enicolas72/m-card/marketing/build/img/IMG_0931.jpg

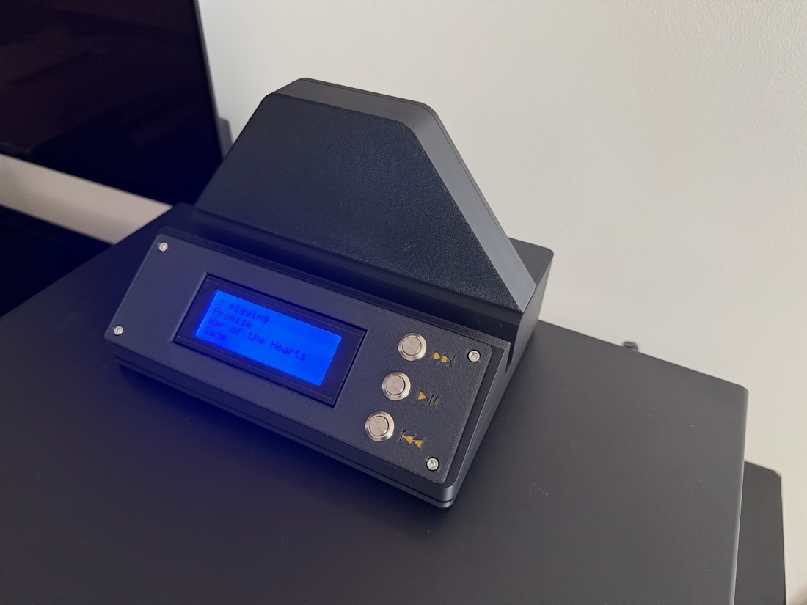
marketing/build/img/IMG_0931.jpg
