enicolas72/m-card/marketing/build/img/IMG_0930.jpg

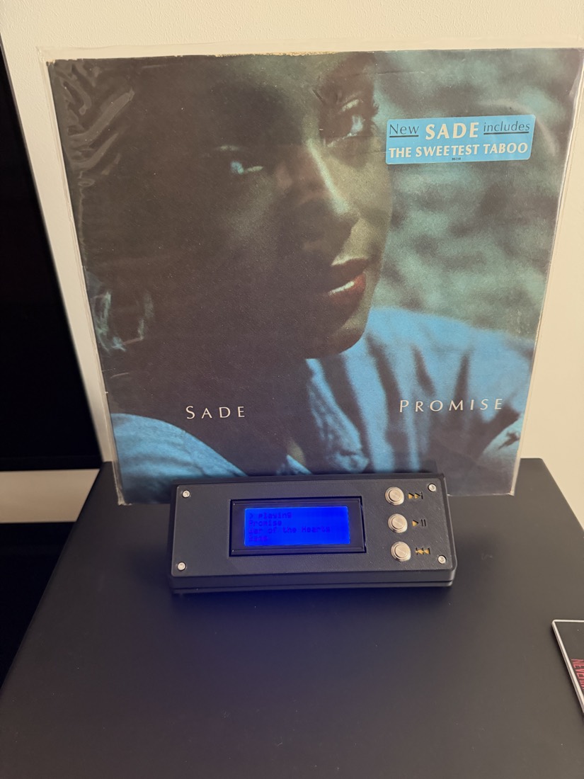
marketing/build/img/IMG_0930.jpg
