enicolas72/m-card/README.md

# M-Card

**Re-materialize your music.** One card per album, or one tucked inside the vinyl
sleeve you already own: drop it in the slot and the album plays on **Roon**. No app,
no phone, no cloud.

👉 **[See M-Card in action: interactive 3D, display, web console](https://enicolas72.github.io/m-card/marketing/)**

An open-source DIY device: Raspberry Pi 3 B+, ACR122U NFC reader, 20×4 LCD,
three push buttons, and a 3D-printed enclosure.

## Repository

The current device is **prototype 2**, archived as a whole in [`proto2/`](proto2/)
(working and in daily use; the paths below). **Prototype 3** is in progress in
[`proto3/`](proto3/), evolving from a copy of proto 2.

| Path | Contents |
|---|---|
| [`proto2/software/`](proto2/software/) | Python application (`mcard/`), sample configs, `install.sh`, systemd service, tests |
| [`proto2/docs/BOM.md`](proto2/docs/BOM.md) | bill of materials, no custom PCB |
| [`proto2/docs/WIRING.md`](proto2/docs/WIRING.md) | full wiring + [SVG diagram](proto2/docs/wiring-diagram.svg) |
| [`proto2/docs/SETUP.md`](proto2/docs/SETUP.md) | SD card, install, Roon pairing, web console, troubleshooting |
| [`proto2/docs/ASSEMBLY.md`](proto2/docs/ASSEMBLY.md) | assembly into the enclosure |
| [`proto2/enclosure/`](proto2/enclosure/) | parametric 3D enclosure (OpenSCAD) + print-ready STLs |
| [`marketing/`](marketing/) | the presentation page: one self-contained offline HTML file, sources in `marketing/build/` |

## Build one

1. **Order** the few parts listed in the [BOM](proto2/docs/BOM.md).
2. **Wire** the LCD and buttons ([WIRING.md](proto2/docs/WIRING.md)); plug the ACR122U into USB.
3. **Install** on the Pi ([SETUP.md](proto2/docs/SETUP.md)): `sudo bash install.sh`.
4. **Enable** the M-Card extension in Roon → Settings → Extensions.
5. **Pair cards**: an unknown card shows up as `TODO` in `albums.yaml`. Open
   `http://mcard.local:8088/search`, find the album, and click *Assign to this card*.
   This writes an exact Roon path, e.g. `path: ["Library", "Artists", "<artist>", "<album>"]`.
6. **Print** the enclosure and assemble it ([ASSEMBLY.md](proto2/docs/ASSEMBLY.md)).

The web console speaks English or French (`web.language: en | fr` in `mcard.yaml`).

Back up your card mappings at any time:

```bash
curl -fsS http://mcard.local:8088/config/albums.yaml/download -o backups/albums-$(date +%Y%m%d-%H%M).yaml
```

## Try it without hardware

```bash
cd proto2/software && python3 -m venv .venv && ./.venv/bin/pip install flask pyyaml pytest
./.venv/bin/python -m mcard --config <config-dir> --fake
./.venv/bin/python -m pytest tests/
```

In `--fake` mode, type a card UID + Enter to "place" a card and Enter alone to remove
it. The LCD is drawn in the terminal and Roon is simulated.

## Software architecture

A single event queue, one central controller, and one thread per peripheral. Every
hardware component has a fake twin, so development needs no Pi:

```
nfc_reader (thread) ──┐                         ┌──► roon_client ──► Roon API
buttons    (GPIO)  ───┼──► queue ──► controller ─┼──► display ──► LCD (I²C)
roon callbacks ───────┘                         └──► albums.yaml (auto TODO entries)
                    webserver (Flask): status / logs / config / Roon library search
```

## License & credits

Code, documentation and enclosure files are released under the [MIT License](LICENSE).

Independent DIY project, not affiliated with or endorsed by Roon Labs. Roon is a
trademark of Roon Labs LLC. Album artwork shown on the presentation page (and in
`marketing/build/cards/`) belongs to its respective owners and is not covered by
the MIT License.
