enicolas72/m-card/marketing/build/stl/shell.stl

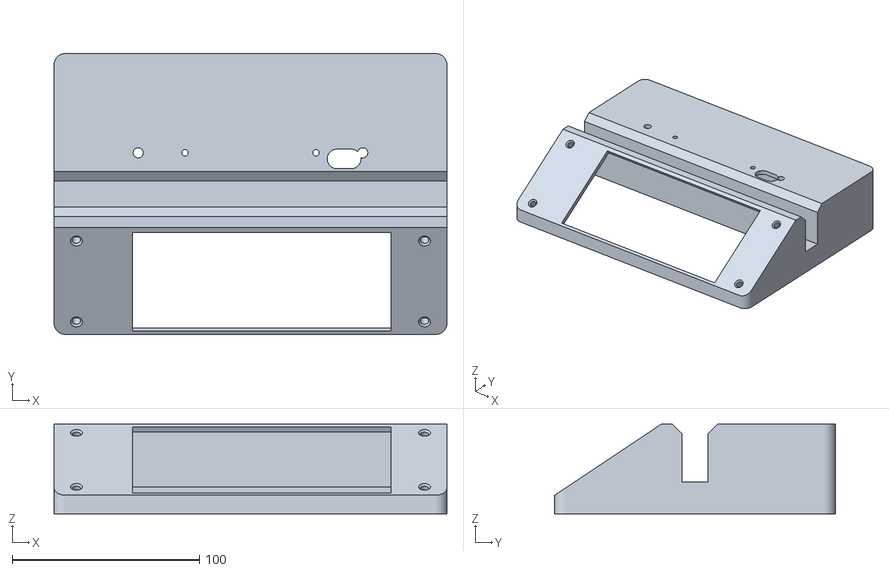
[picture p3: CAD file, 2026-10-18]
marketing/build/stl/shell.stl
210.0 x 150.0 x 48.0
