enicolas72/m-card/proto3/enclosure/stl/icon_plate.stl

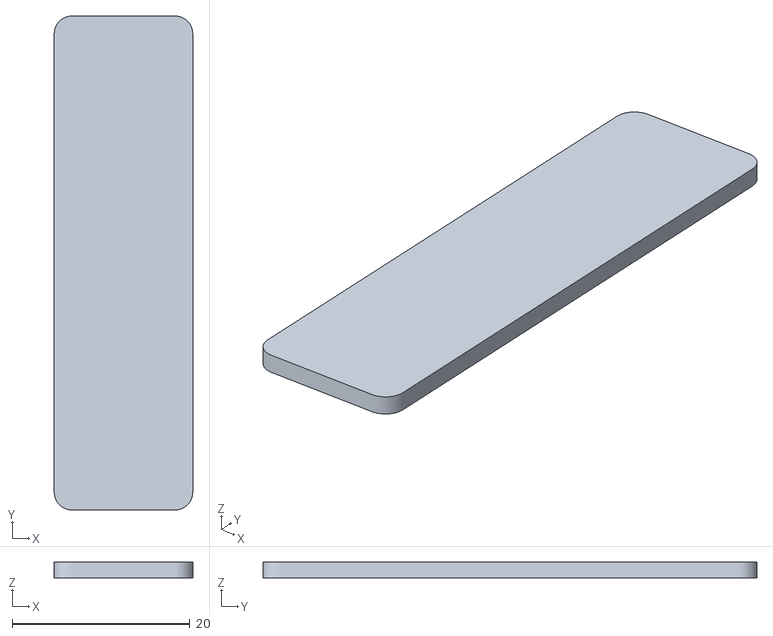
[picture p4: CAD file, 2026-07-30]
proto3/enclosure/stl/icon_plate.stl
15.6 x 55.6 x 1.80
