enicolas72/m-card/marketing/build/stl/lid.stl

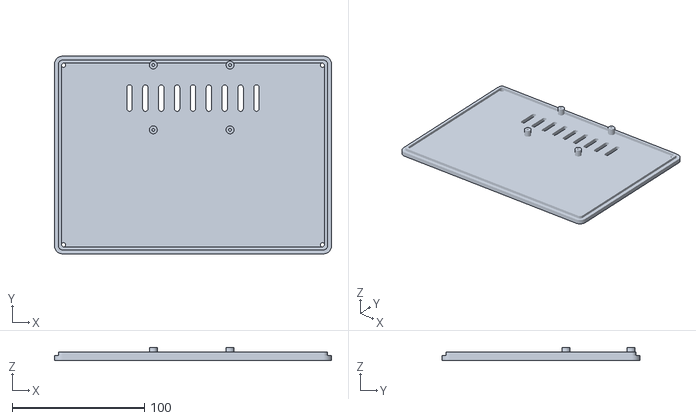
[picture p5: CAD file, 2026-10-18]
marketing/build/stl/lid.stl
209.4 x 149.4 x 9.99
