enicolas72/m-card/proto3/enclosure/stl/backrest.stl

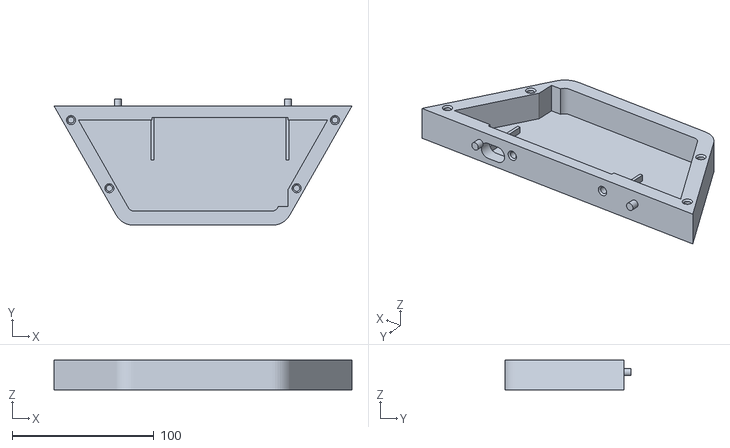
[picture p6: CAD file, 2026-07-30]
proto3/enclosure/stl/backrest.stl
210.0 x 89.0 x 21.0
