enicolas72/m-card/marketing/build/stl/faceplate.stl

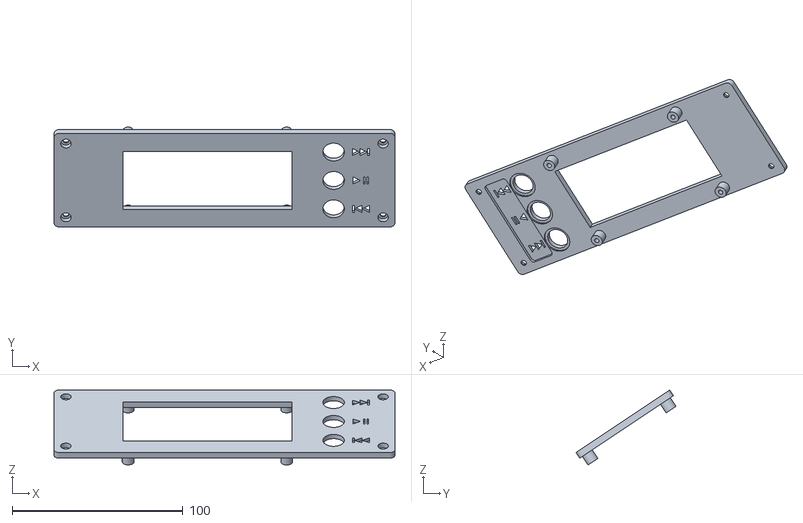
[picture p7: CAD file, 2026-10-18]
marketing/build/stl/faceplate.stl
200.0 x 58.6 x 43.9
