enicolas72/m-card/proto3/enclosure/stl/faceplate.stl

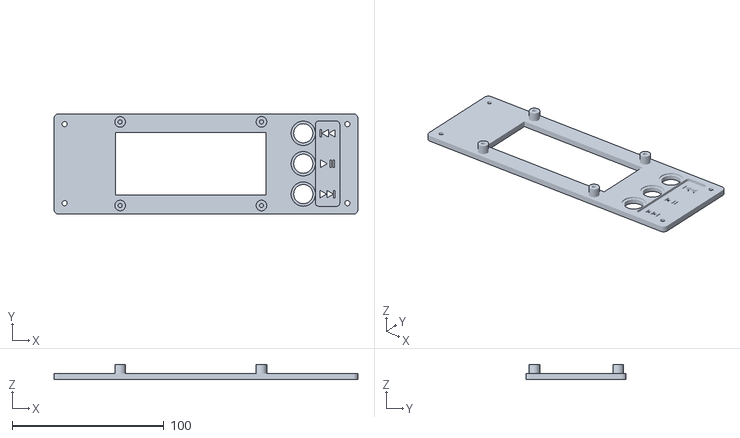
[picture p8: CAD file, 2026-07-30]
proto3/enclosure/stl/faceplate.stl
200.0 x 66.0 x 10.0
