enicolas72/m-card/marketing/build/stl/lcd_bezel.stl

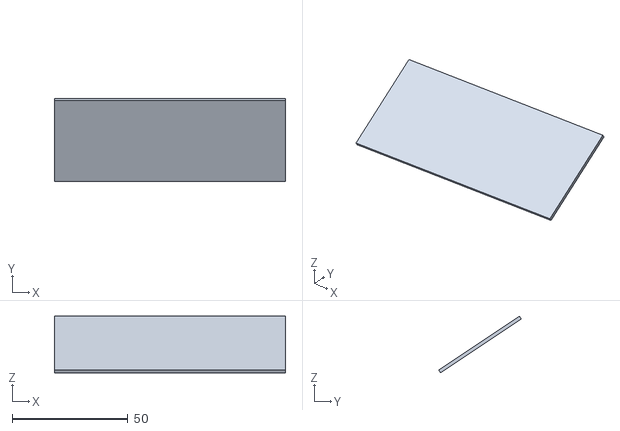
[picture p9: CAD file, 2026-10-18]
marketing/build/stl/lcd_bezel.stl
100.0 x 35.7 x 24.5
