enicolas72/m-card/proto3/enclosure/stl/backrest_cover.stl

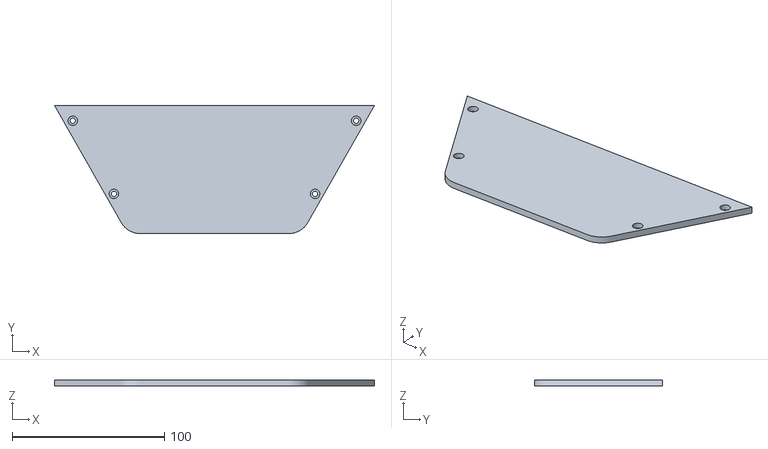
[picture p10: CAD file, 2026-07-30]
proto3/enclosure/stl/backrest_cover.stl
210.0 x 84.0 x 4.00
