enicolas72/m-card/marketing/build/stl/icon_plate.stl

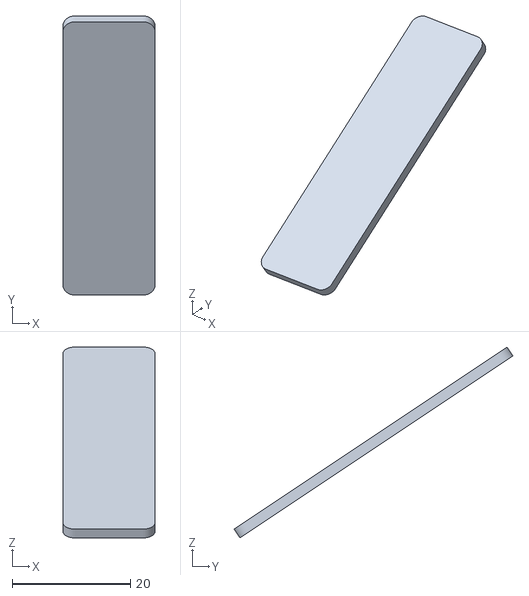
[picture p11: CAD file, 2026-10-18]
marketing/build/stl/icon_plate.stl
15.6 x 47.3 x 32.3
