enicolas72/m-card/marketing/build/stl/usbc_body.stl

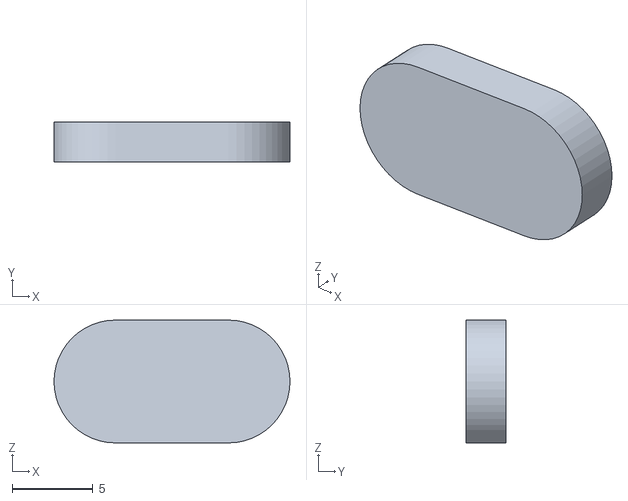
[picture p12: CAD file, 2026-10-18]
marketing/build/stl/usbc_body.stl
14.6 x 2.50 x 7.60
