enicolas72/m-card/marketing/build/stl/lcd_screen.stl

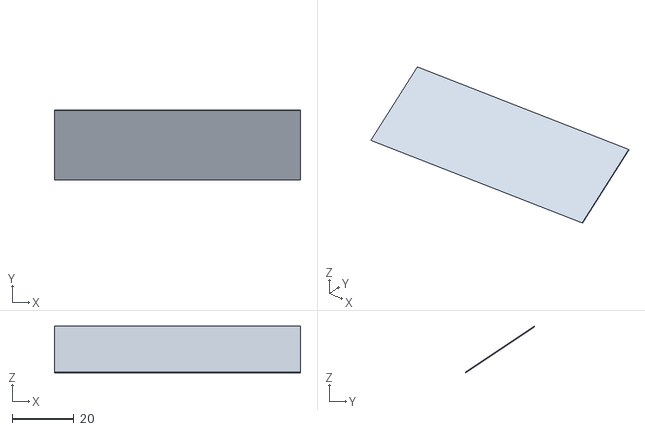
[picture p13: CAD file, 2026-10-18]
marketing/build/stl/lcd_screen.stl
80.0 x 22.6 x 15.2
