enicolas72/m-card/marketing/build/stl/usbc_slot.stl

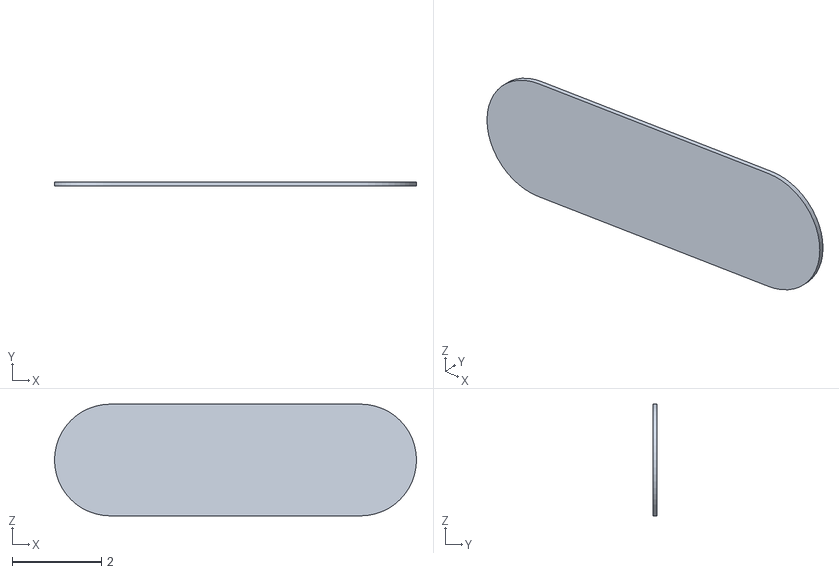
[picture p14: CAD file, 2026-10-18]
marketing/build/stl/usbc_slot.stl
8.10 x 0.1 x 2.50
