enicolas72/m-card/marketing/build/stl/buttons.stl

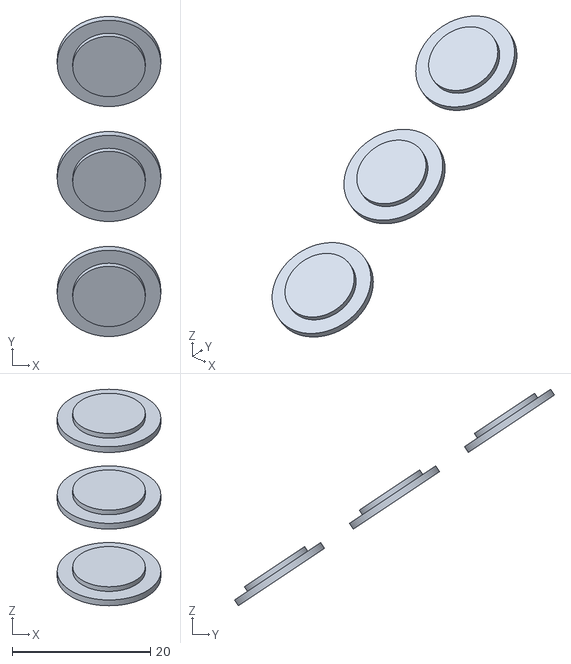
[picture p15: CAD file, 2026-10-18]
marketing/build/stl/buttons.stl
15.0 x 46.3 x 31.3
