enicolas72/m-card/marketing/build/stl/usbc_metal.stl

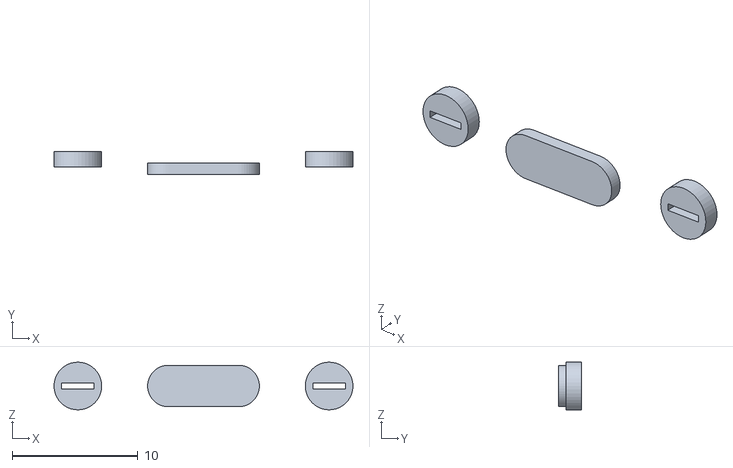
[picture p16: CAD file, 2026-10-18]
marketing/build/stl/usbc_metal.stl
23.8 x 1.80 x 3.80
