enicolas72/m-card/(list of files, cad)

Other CAD files:
marketing/build/stl/backrest_cover.stl
proto3/enclosure/stl/shell.stl
proto3/enclosure/stl/lid.stl
marketing/build/stl/backrest.stl
marketing/build/stl/screws.stl
