enicolas72/m-card/marketing/build/capture/status.html

# M-Card

Roon | connected simulated
State | playing
Album | Rumours
Track | Track 1
Artist | Fleetwood Mac
Card in slot | 042F9B7AAA4880
Card album | Rumours
