enicolas72/m-card/marketing/build/capture/config.html

# M-Card

## albums.yaml

download

# M-Card — RFID card -> Roon album mapping # # Each key is the card's hexadecimal UID (shown on the LCD and in the logs # when an unknown card is placed). # # Accepted formats for each entry: # "UID": # path: ["Library", "Artists", "Miles Davis", "Kind of Blue"] # recommended # artist: "Miles Davis" # optional (info) # or the album title alone (matched tolerantly against the library): # "UID": # album: "Kind of Blue" # # An `album: TODO` entry is added automatically when an unknown card is # placed: pair it from the /search page of the web console, which writes # the exact `path:` for you. "042F9B7AAA4880": path: ["Library", "Artists", "Fleetwood Mac", "Rumours"] artist: "Fleetwood Mac" "042F9B7AAA4881": path: ["Library", "Artists", "Jean-Michel Jarre", "Electronica 1: The Time Machine"] artist: "Jean-Michel Jarre" "042F9B7AAA4882": path: ["Library", "Artists", "Norah Jones", "Come Away with Me"] artist: "Norah Jones" "042F9B7AAA4883": path: ["Library", "Artists", "Pink Floyd", "The Division Bell"] artist: "Pink Floyd" "042F9B7AAA4884": path: ["Library", "Artists", "Diana Krall", "The Girl in the Other Room"] artist: "Diana Krall" "042F9B7AAA4885": path: ["Library", "Artists", "AC/DC", "For Those About to Rock We Salute You"] artist: "AC/DC" "042F9B7AAA4886": path: ["Library", "Artists", "Michael Jackson", "Thriller"] artist: "Michael Jackson" "042F9B7AAA4887": path: ["Library", "Artists", "Supertramp", "Breakfast in America"] artist: "Supertramp" "042F9B7AAA4888": path: ["Library", "Artists", "The Cure", "Seventeen Seconds"] artist: "The Cure" "042F9B7AAA4889": album: "TODO"

Save
