enicolas72/m-card/marketing/build/capture/search.html

# M-Card

## Search Roon

Search

2 album(s) — copy under the card's UID in albums.yaml, or assign directly to a card.

Electronica 1: The Time Machine
Jean-Michel Jarre
path: ["Library", "Artists", "Jean-Michel Jarre", "Electronica 1: The Time Machine"]
artist: "Jean-Michel Jarre"
Assign to this card

Electronica 2: The Heart of Noise
Jean-Michel Jarre
path: ["Library", "Artists", "Jean-Michel Jarre", "Electronica 2: The Heart of Noise"]
artist: "Jean-Michel Jarre"
Assign to this card
