enicolas72/m-card/marketing/build/cards/acdc.jpg

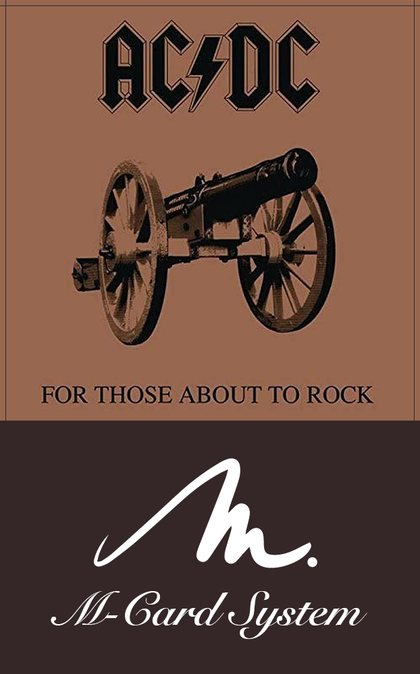
marketing/build/cards/acdc.jpg
