enicolas72/m-card/marketing/build/cards/cure.jpg

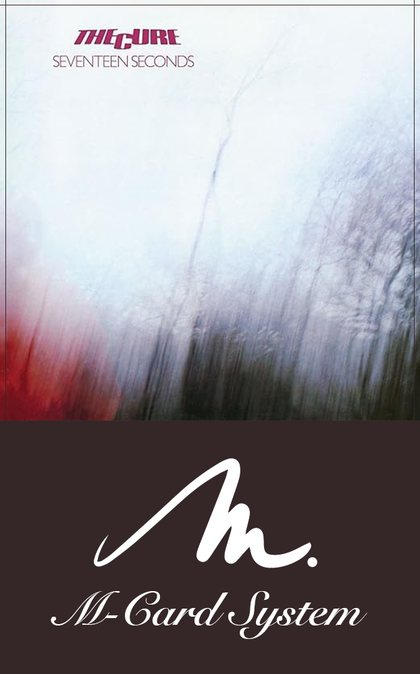
marketing/build/cards/cure.jpg
