enicolas72/m-card/marketing/build/cards/division_bell.jpg

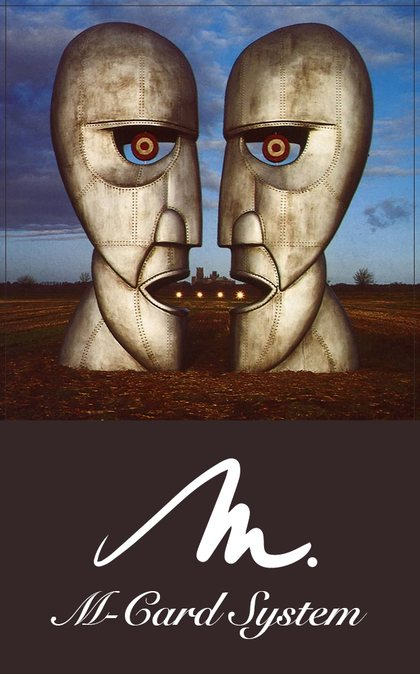
marketing/build/cards/division_bell.jpg
