enicolas72/m-card/marketing/build/cards/jarre1.jpg

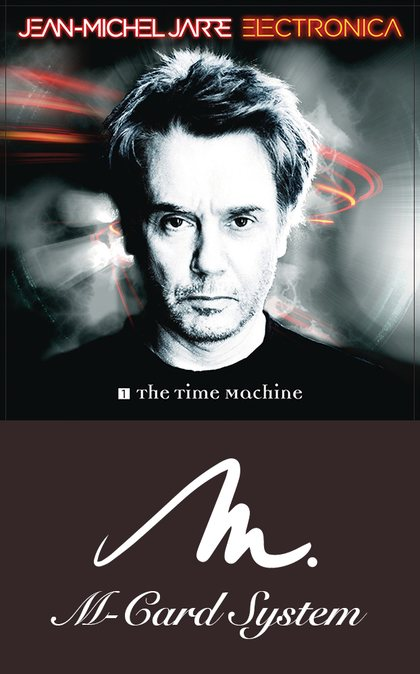
marketing/build/cards/jarre1.jpg
