enicolas72/m-card/marketing/build/cards/jarre2.jpg

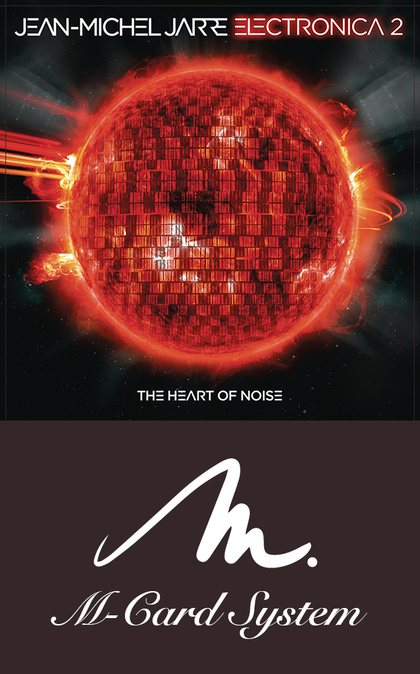
marketing/build/cards/jarre2.jpg
