enicolas72/m-card/marketing/build/cards/krall.jpg

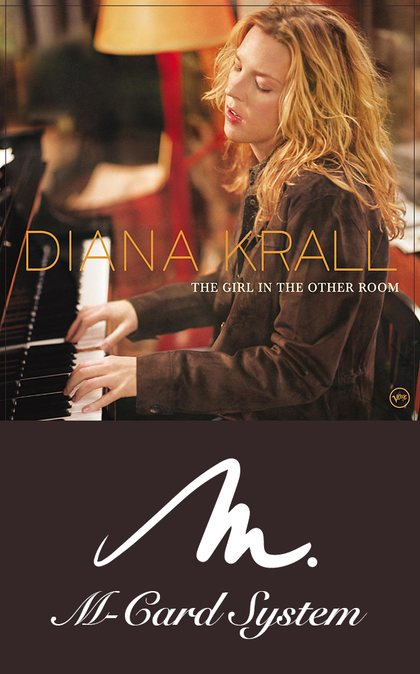
marketing/build/cards/krall.jpg
