enicolas72/m-card/marketing/build/cards/norah.jpg

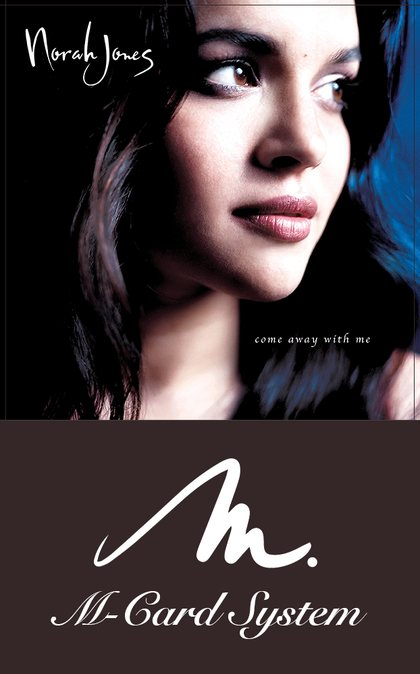
marketing/build/cards/norah.jpg
