enicolas72/m-card/marketing/build/cards/rumours.jpg

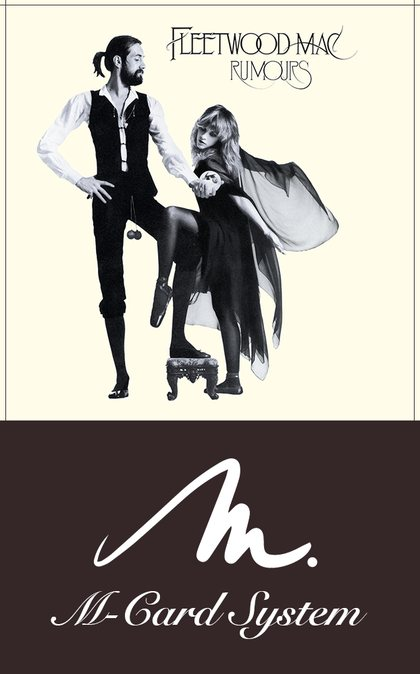
marketing/build/cards/rumours.jpg
