enicolas72/m-card/marketing/build/cards/supertramp.jpg

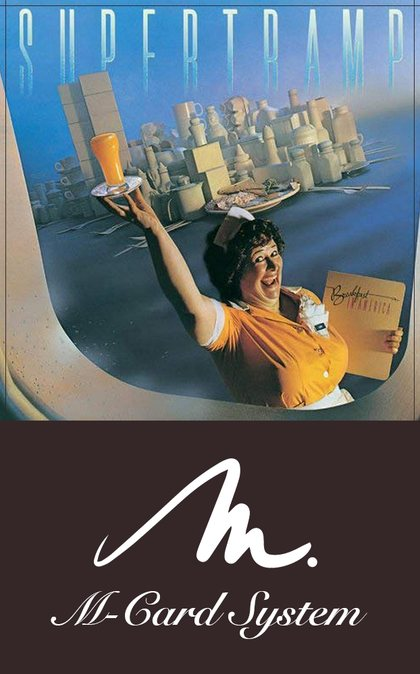
marketing/build/cards/supertramp.jpg
