enicolas72/m-card/marketing/build/cards/thriller.jpg

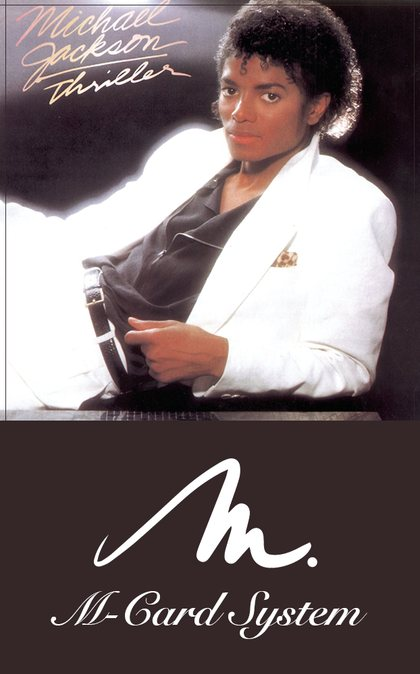
marketing/build/cards/thriller.jpg
