enicolas72/m-card/proto3/enclosure/assembly_back.png

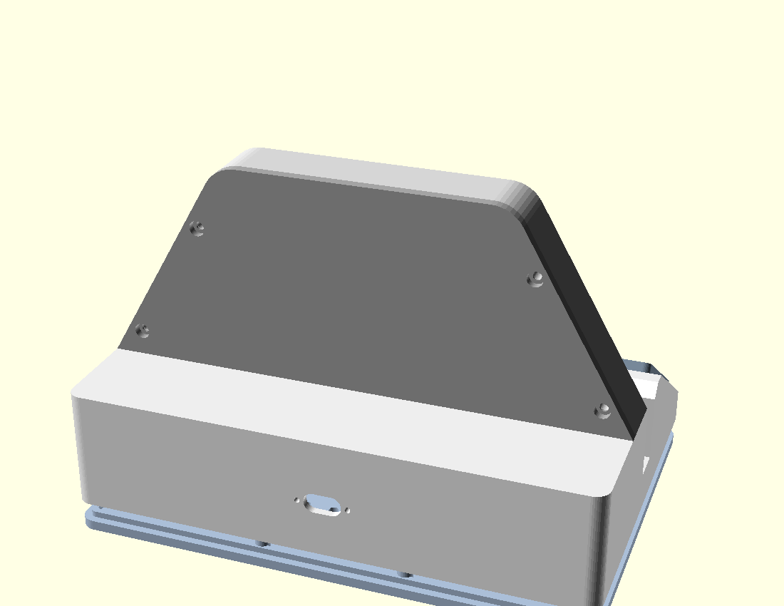
proto3/enclosure/assembly_back.png
