enicolas72/m-card/proto3/enclosure/assembly_front.png

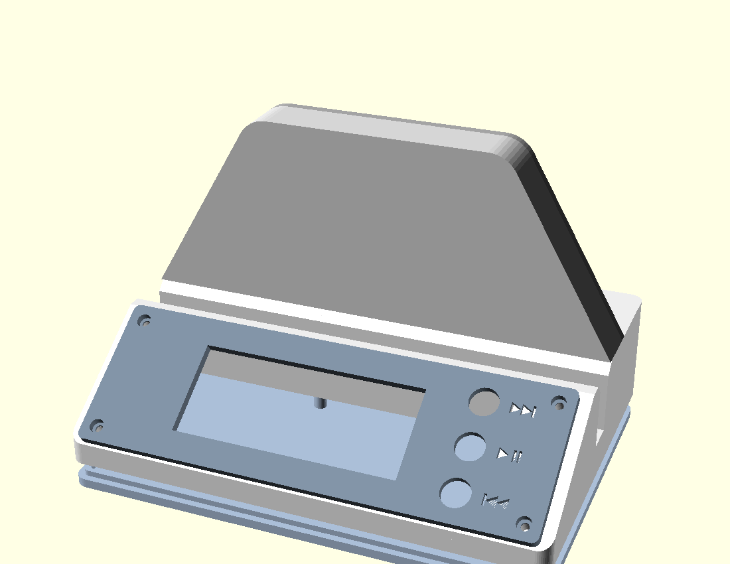
proto3/enclosure/assembly_front.png
