enicolas72/m-card/proto3/software/mcard/logging_setup.py

"""Logging setup: rotating file + console (journalctl)."""

from __future__ import annotations

import logging
import logging.handlers
from pathlib import Path

FORMAT = "%(asctime)s %(levelname)-7s %(name)s: %(message)s"


def setup_logging(log_file: str | Path, level: str = "INFO",
                  max_bytes: int = 1_000_000, backup_count: int = 5) -> Path:
    log_file = Path(log_file)
    log_file.parent.mkdir(parents=True, exist_ok=True)

    root = logging.getLogger()
    root.setLevel(getattr(logging, level.upper(), logging.INFO))

    file_handler = logging.handlers.RotatingFileHandler(
        log_file, maxBytes=max_bytes, backupCount=backup_count, encoding="utf-8"
    )
    file_handler.setFormatter(logging.Formatter(FORMAT))
    root.addHandler(file_handler)

    console = logging.StreamHandler()
    console.setFormatter(logging.Formatter(FORMAT))
    root.addHandler(console)

    # the built-in web server is chatty on every request
    logging.getLogger("werkzeug").setLevel(logging.WARNING)
    return log_file
