enicolas72/m-card/(commit log)

2026-07-26 Premier jet complet : logiciel, câblage, boîtier 3D, docs — breadboard validé
    Lecteur d'albums Roon par carte RFID (Pi 3B+, ACR122U, LCD 2004 I2C,
    3 boutons). 35 tests, mode simulé sans matériel, boîtier OpenSCAD + STL.
    Claude-Session: https://claude.ai/code/session_014MdYVd8LhnvQWvzhpTgzgd
    [backrest.stl, backrest_cover.stl, lid.stl, mcard.scad, shell.stl]
2026-07-26 Résolution tolérante des noms d'albums contre la bibliothèque Roon
    play_media exige le titre exact (casse/accents) et son retour est
    inexploitable : le titre canonique est désormais résolu avant lecture
    (browse paginé, cache 5 min), avec suggestions loggées si ambigu.
    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
2026-07-28 Boîtier : icônes ⏮ ⏯ ⏭ en relief sur la façade au-dessus des boutons
    Glyphes 2D extrudés (0,6 mm de relief, paramétrables), shell.stl
    régénéré, aperçus mis à jour.
    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
    [mcard.scad, shell.stl]
2026-07-29 Dosseret : logement ACR122U aux cotes réelles (62x93 portrait, antenne en bas)
    Carte nue mesurée 60x91 mm ; logement portrait avec antenne centrée face
    à la carte RFID, câble vers le haut. STL du dosseret régénérés.
    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
    [backrest.stl, backrest_cover.stl, mcard.scad]
2026-07-29 Boîtier V0.3 « agitateur magnétique » + retrait de carte non bloquant
    Socle 48 mm à console inclinée (façade rapportée LCD/boutons), dosseret
    trapézoïdal creux pleine largeur (lecteur en paysage, plaque arrière
    affleurante), poches à inserts et lamages calés sur la quincaillerie
    réelle (Hangtife M3x5x4, vis CHC). Logiciel : on_card_removed=none par
    défaut, l'album continue quand on retire le CD. 46 tests.
    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
    [backrest.stl, backrest_cover.stl, faceplate.stl, lid.stl, mcard.scad, shell.stl]
2026-07-30 Icônes couleur ajourées (plaquette collée) ; dosseret : lecteur logé, câble débouchant
    Façade : glyphes traversants + lamage au dos pour une plaquette
    contrastée (nouvelle pièce icon_plate). Dosseret : sommet élargi à 126
    (le lecteur paysage sortait du volume), logement rectangulaire garanti,
    passage câble avec 2 mm de recouvrement, vis de plaque recalculées.
    Vérifications par intersections OpenSCAD automatiques.
    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
    [backrest.stl, backrest_cover.stl, faceplate.stl, icon_plate.stl, mcard.scad]
2026-07-30 Photos du prototype 2 assemblé (hardware/proto2) + une dans le README
    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
2026-07-30 Réorganisation des répertoires : enclosure/ à la racine, archives dans versions/
    Références des docs mises à jour (README, CLAUDE.md, ASSEMBLY, BOM).
    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
    [backrest.stl, backrest_cover.stl, faceplate.stl, icon_plate.stl, lid.stl, mcard.scad, shell.stl]
2026-10-18 Page /search : recherche d'albums Roon et association carte → path exact
2026-10-18 Page de présentation autonome (marketing/) : 3D temps réel, LCD émulé, console
    [backrest.stl, backrest_cover.stl, buttons.stl, faceplate.stl, icon_plate.stl, lcd_bezel.stl, lcd_screen.stl, lid.stl]
2026-10-18 Translate the whole codebase and device UI to English; untrack versions/
    [mcard.scad, parts.scad]
2026-10-23 Archive prototype 2 (software, enclosure, docs) in proto2/ before starting prototype 3
    [backrest.stl, backrest_cover.stl, faceplate.stl, icon_plate.stl, lid.stl, mcard.scad, parts.scad, shell.stl]
2026-10-23 Open prototype 3 in proto3/, starting from a copy of proto 2
    [backrest.stl, backrest_cover.stl, faceplate.stl, icon_plate.stl, lid.stl, mcard.scad, shell.stl]
